bigbass1997/PIC-CNT64/pinout.xlsx

Sheet: Microcontroller
Notes | I/O | Usage | Name | Pin |  | Pin | Name | Usage | I/O | Notes | Color Scheme
 | O | VPP/MCLR | RE3 | 1 | PIC18LF57K42 | 40 | RB7 | ICSPDAT | O |  | PORTA
 | I | A | RA0 | 2 |  | 39 | RB6 | ICSPCLK | O |  | PORTB
 | I | B | RA1 | 3 |  | 38 | RB5 | XA | I | IOC | PORTC
 | I | cU | RA2 | 4 |  | 37 | RB4 | XB | I |  | PORTD
 | I | cD | RA3 | 5 |  | 36 | RB3 | YB | I |  | PORTE
 | I | cL | RA4 | 6 |  | 35 | RB2 | YA | I | IOC | ICSP
 | I | cR | RA5 | 7 |  | 34 | RB1 | SDO | O | SPI1 TX
 | I | LT | RE0 | 8 |  | 33 | RB0 | SCK | O | SPI1 TX
 | I | RT | RE1 | 9 |  | 32 | VDD
 | I | START | RE2 | 10 |  | 31 | VSS
 |  |  | VDD | 11 |  | 30 | RD7 | U2TX | O | UART2 TX
 |  |  | VSS | 12 |  | 29 | RD6 | ADDR_LAT | O | SPI1 TX
 |  |  | RA7 | 13 |  | 28 | RD5
 |  |  | RA6 | 14 |  | 27 | RD4 | PAK_OE | O
 | I | dU | RC0 | 15 |  | 26 | RC7 | PAK_RW | O
 | I | dD | RC1 | 16 |  | 25 | RC6 | IO_OE1 | O
 | I | dL | RC2 | 17 |  | 24 | RC5 | IO_SER_IN | I
 | I | dR | RC3 | 18 |  | 23 | RC4 | IO_S1 | O
 | I | Z | RD0 | 19 |  | 22 | RD3 | IO_SER_OUT | O
 | I | DATA_IO | RD1 | 20 |  | 21 | RD2 | IO_CLK | O

Sheet: Accessory Paks
Side | Front/Top of PAK PCB
Name | D3 | 3.3V | D4 | D5 | D6 | D7 | A10 | /OE | A11 | A9 | A8 | A13 | /WE | A15 | CE | GND
Pin | 32 | 31 | 30 | 29 | 28 | 27 | 26 | 25 | 24 | 23 | 22 | 21 | 20 | 19 | 18 | 17
Pin | 16 | 15 | 14 | 13 | 12 | 11 | 10 | 9 | 8 | 7 | 6 | 5 | 4 | 3 | 2 | 1
Name | D2 | 3.3V | DETECT | D1 | D0 | A0 | A1 | A2 | A3 | A4 | A5 | A6 | A7 | A12 | A14 | GND
Side | Back/Bottom (usually with battery)

Sheet: Transfer Pak Ribbon
Side | Gameboy Slot |  |  |  |  |  |  |  |  |  |  |  |  |  |  |  |  |  |  |  |  |  |  |  |  |  |  |  |  |  | Side
 | Top Face of Transfer Pak PCB
Pin | 30 | 29 | 28 | 27 | 26 | 25 | 24 | 23 | 22 | 21 | 20 | 19 | 18 | 17 | 16 | 15 | 14 | 13 | 12 | 11 | 10 | 9 | 8 | 7 | 6 | 5 | 4 | 3 | 2 | 1 | Pin
Name | GND | D3 | D2 | 3.3V | D4 | D5 | D1 | D6 | D0 | D7 | A0 | A10 | A1 | /OE | A2 | A11 | A3 | A9 | A4 | A8 | A5 | A13 | A6 | /WE | A7 | A15 | A12 | CE | A14 | GND | Name
Side | Ribbon Cable from Pak Connector |  |  |  |  |  |  |  |  |  |  |  |  |  |  |  |  |  |  |  |  |  |  |  |  |  |  |  |  |  | Side
