bigbass1997/PIC-CNT64/images/analogStickPinoutDiagram.png

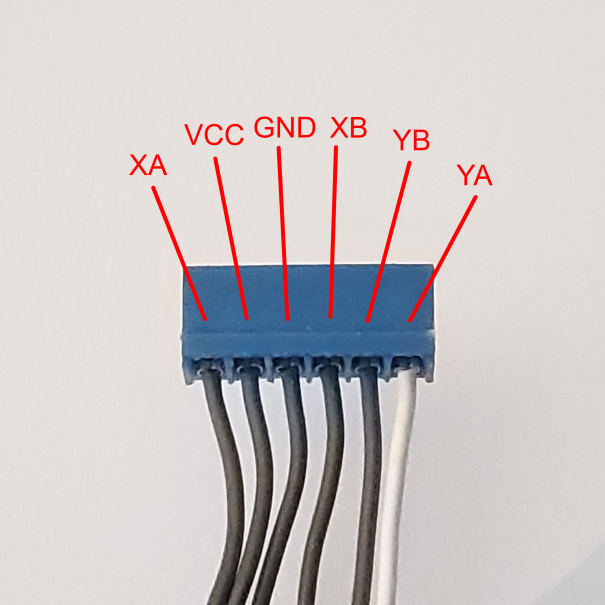
images/analogStickPinoutDiagram.png
