bigbass1997/PIC-CNT64/pcb-schematic/pic-cnt64.sch

## KiCad design pcb-schematic/pic-cnt64.sch (2020-07-01, last stored version)

Schematic: pic-cnt64.sch

Parts:
C1, C2, C3, C4, C5, C6, C7, C8, C10, C11, C13, C14, C15, C16: 0.1uF; C_Disc_D10.5mm_W5.0mm_P5.00mm
C9, C12: 27pF; C_Disc_D3.4mm_W2.1mm_P2.50mm
J1: Analog Stick; JST_PH_B6B-PH-K_1x06_P2.00mm_Vertical
J2: Controller Port; JST_XH_B3B-XH-A_1x03_P2.50mm_Vertical
R1, R2, R5, R6, R9, R10, R13, R14, R17, R18, R21, R22, R25, R26, R29, R30, R31, R32, R33, R34, R35, R36, R37, R38, R39, R40, R41, R42: 10k; R_Axial_DIN0207_L6.3mm_D2.5mm_P10.16mm_Horizontal
R3, R4, R7, R8, R11, R12, R15, R16, R19, R20, R23, R24, R27, R28: 100k; R_Axial_DIN0207_L6.3mm_D2.5mm_P10.16mm_Horizontal
SW1, SW15: PIN_START; SW_PUSH_6mm_H5mm
SW2, SW16: PIN_dR; SW_PUSH_6mm_H5mm
SW3, SW17: PIN_RT; SW_PUSH_6mm_H5mm
SW4, SW18: PIN_dL; SW_PUSH_6mm_H5mm
SW5, SW19: PIN_LT; SW_PUSH_6mm_H5mm
SW6, SW20: PIN_dD; SW_PUSH_6mm_H5mm
SW7, SW21: PIN_cR; SW_PUSH_6mm_H5mm
SW8, SW22: PIN_dU; SW_PUSH_6mm_H5mm
SW9, SW23: PIN_cL; SW_PUSH_6mm_H5mm
SW10, SW24: PIN_Z; SW_PUSH_6mm_H5mm
SW11, SW25: PIN_cD; SW_PUSH_6mm_H5mm
SW12, SW26: PIN_B; SW_PUSH_6mm_H5mm
SW13, SW27: PIN_cU; SW_PUSH_6mm_H5mm
SW14, SW28: PIN_A; SW_PUSH_6mm_H5mm
U1: PIC18LF4550-IP-PinAligned; DIP-40_W15.24mm
Y1: 8MHz; Crystal_HC49-4H_Vertical

Notes on the sheet:
Crystal Oscillator
Button Inputs Option #1 (with debounce)
Connector Pin Headers
Microcontroller
Alternative Input Pin Headers
Button Inputs Option #2 (without debounce)
All PIN_? inputs should be pulled low when not pressed. If not utilizing any kind of debounce circuit like in Option #1, use Option #2.
