bigbass1997/PIC-CNT64/(commit log)

2020-06-22 Fixed a broken link
    [main.asm]
2020-06-22 Implemented all of the button input pins as mapped in the pinout.xls spreadsheet.
2020-06-23 Combined N64 DATA Input/Output pins into a single pin which toggles I/O as needed; rather than having an input and output dangerously connected together.
    [pinout.xls]
2020-06-23 Added microcontroller pinout schematic image.
2020-06-24 Added KiCad schematic. Added wavedrom JSON file used for the wiki.
    [pic-cnt64.sch]
2020-07-01 Changed symbol for the MCU, added non-debounce circuit option.
    [pic-cnt64.sch]
2020-07-03 Implemented 0xFF command response and resetting x/y-axis when RST is true.
    [main.asm]
2020-07-31 Cleaned and prepared code for accessory PAK compatibility
    [pinout.xls, pinout.xlsx]
2020-09-15 Reorganized code, fixed delay in unimplemented command, and added a delay when no command is recognized
    [main.asm]
2020-09-23 Began optimization to fix desyncs while decoding bytes
    [main.asm]
2020-09-24 Changed entire decoding sequence and methodology. Bytes from the console are now decoded and placed into a section of memory until no more bytes are available. Command byte is still stored in its own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
    [main.asm]
2020-10-03 Began migration to new microcontroller. CRC is now hardware-based and fully working. Unused code cleaned. Repo structure has been reorganized.
    [pic-cnt64.sch, pinout.xlsx]
2020-10-03 Corrected pause timer length due to higher clock speed.
    [main.asm]
2020-10-04 Migrated interrupts for analog stick functionality.
2020-10-11 Unwrapped loops, tried pak reading inbetween transmitting bytes but that won't work. Committing just to save this attempt.
    [main.asm]
2020-10-12 Reading from pak appears to work now. However writing to the pak after handling the CRC is too slow in certain situations. Writing procedure will need parallelization similar to this commit too.
    [main.asm]
2020-10-13 Pak Read/Write Communication Implemented! Both reading from and writing to a pak device is working (only Controller Pak tested but others should work too). Migration complete and beneficial.
    [pinout.xlsx]
2020-11-29 Controller Pak fails to communicate, some WIP code to debug this; possibly has something to do with CE pin always being held LOW.
    [pinout.xlsx]
