bigbass1997/PIC-CNT64/(notices)

Notices in the files:
README.md:
License: GPL v3
